IOSEBI617/trezor-hw/README.md

# Hardware design of TREZOR



https://trezor.io/
IOSEBI
