IOSEBI617/trezor-hw/case/trezor_one/usb_c_v2/case.SLDASM

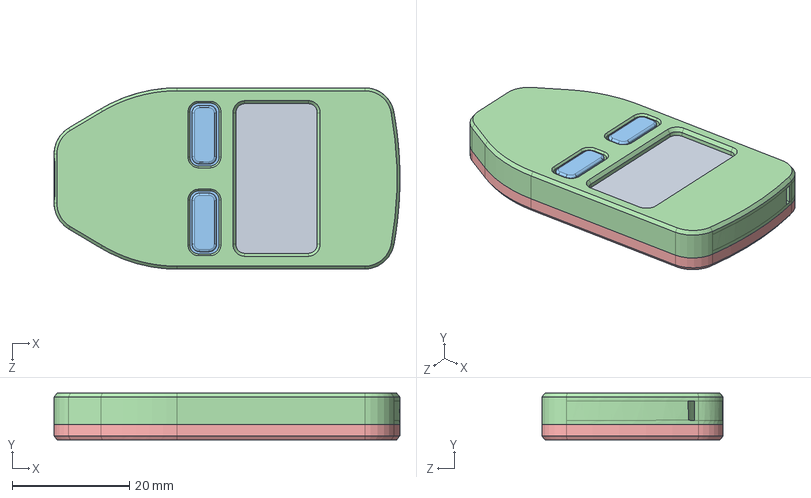
[picture p1: CAD file, 2020-09-01]
case/trezor_one/usb_c_v2/case.SLDASM
58.9 x 7.92 x 30.9 mm
COMPOUND.step
COMPOUND-0.step
SOLID.step
SOLID-1.step x 3
SOLID-2.step x 22
SOLID-3.step
SOLID-4.step
SOLID-5.step
SOLID-6.step x 2
COMPOUND-7.step
buttons
cover-up
cover-down
