IOSEBI617/trezor-hw/case/trezor_one/usb_c_v2/trezor_v1.1_usb_c.SLDASM

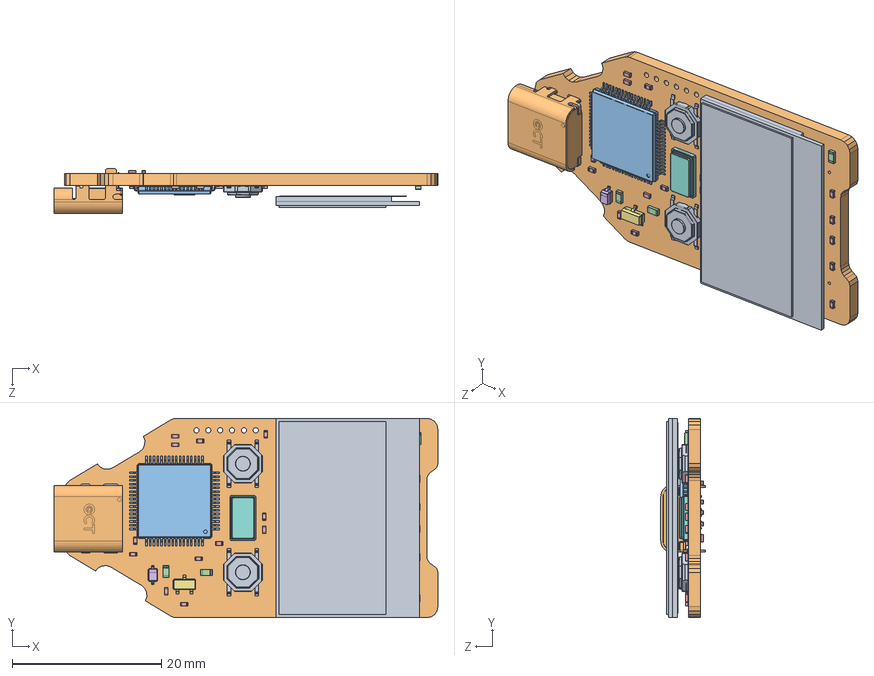
[picture p2: CAD file, 2020-09-01]
case/trezor_one/usb_c_v2/trezor_v1.1_usb_c.SLDASM
51.4 x 26.7 x 5.96 mm
COMPOUND.step
COMPOUND-0.step
SOLID.step
SOLID-1.step x 3
SOLID-2.step x 22
SOLID-3.step
SOLID-4.step
SOLID-5.step
SOLID-6.step x 2
COMPOUND-7.step
