IOSEBI617/trezor-hw/case/trezor_one/v3/buttons.step

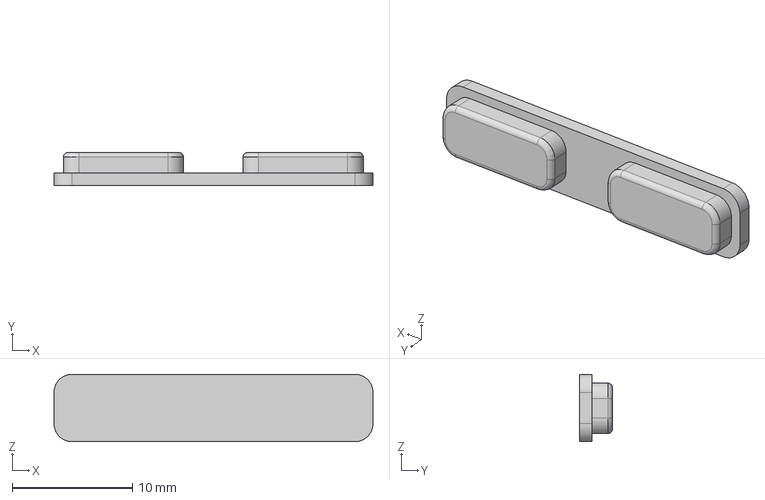
[picture p3: CAD file, 2020-09-01]
case/trezor_one/v3/buttons.step
26.5 x 2.76 x 5.60 mm
