IOSEBI617/trezor-hw/electronics/trezor_v1.1_usb_c/Global_Connector_Technology_-_USB4085-GF-A.step

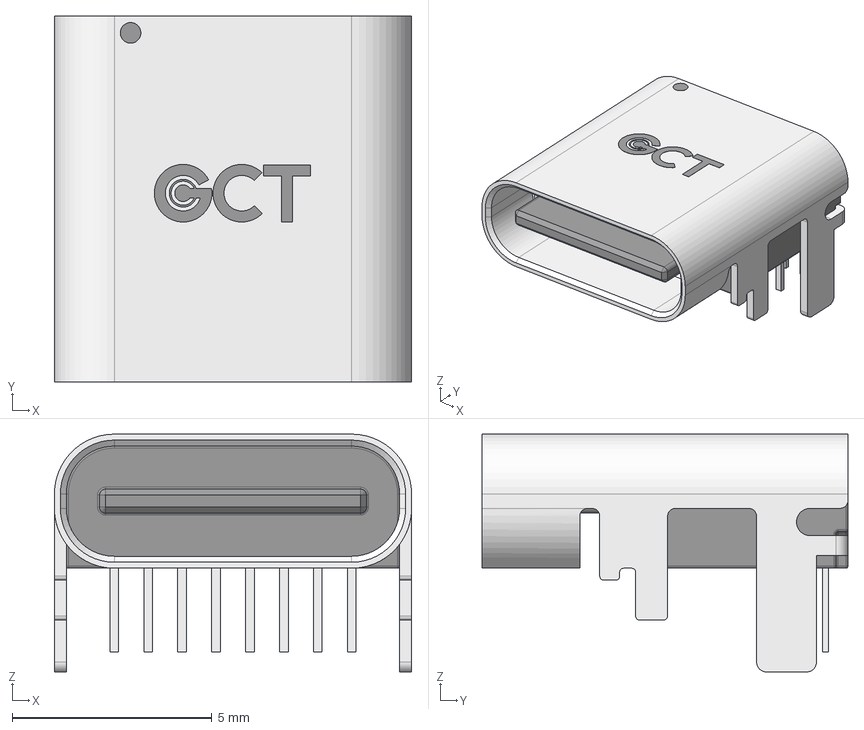
[picture p4: CAD file, 2020-08-25]
electronics/trezor_v1.1_usb_c/Global_Connector_Technology_-_USB4085-GF-A.step
8.95 x 9.17 x 5.96 mm
housing
plastic
pins
logo
