IOSEBI617/trezor-hw/case/trezor_one/v3/cover-up.step

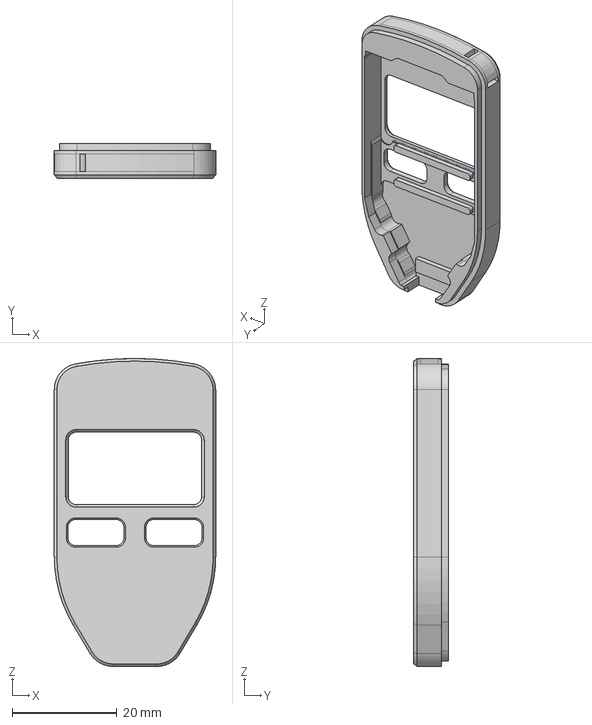
[picture p5: CAD file, 2020-09-01]
case/trezor_one/v3/cover-up.step
30.9 x 6.60 x 58.9 mm
