IOSEBI617/trezor-hw/electronics/trezor_v1.1_usb_c/display.STEP

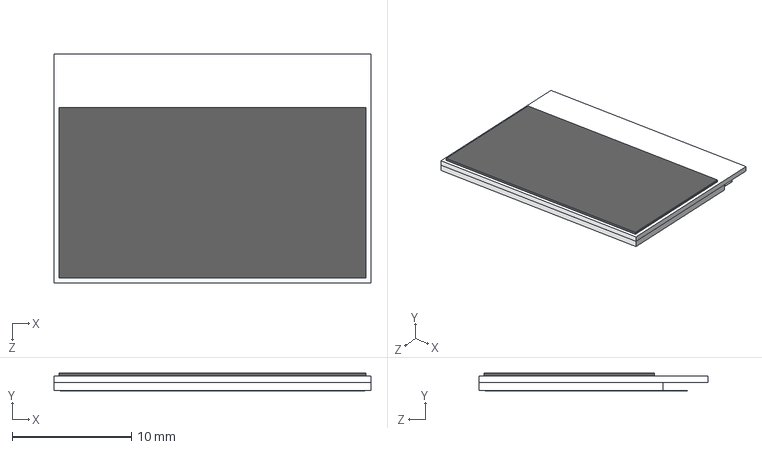
[picture p6: CAD file, 2020-08-25]
electronics/trezor_v1.1_usb_c/display.STEP
26.6 x 1.50 x 19.2 mm
