IOSEBI617/trezor-hw/case/trezor_one/v3/cover-down.step

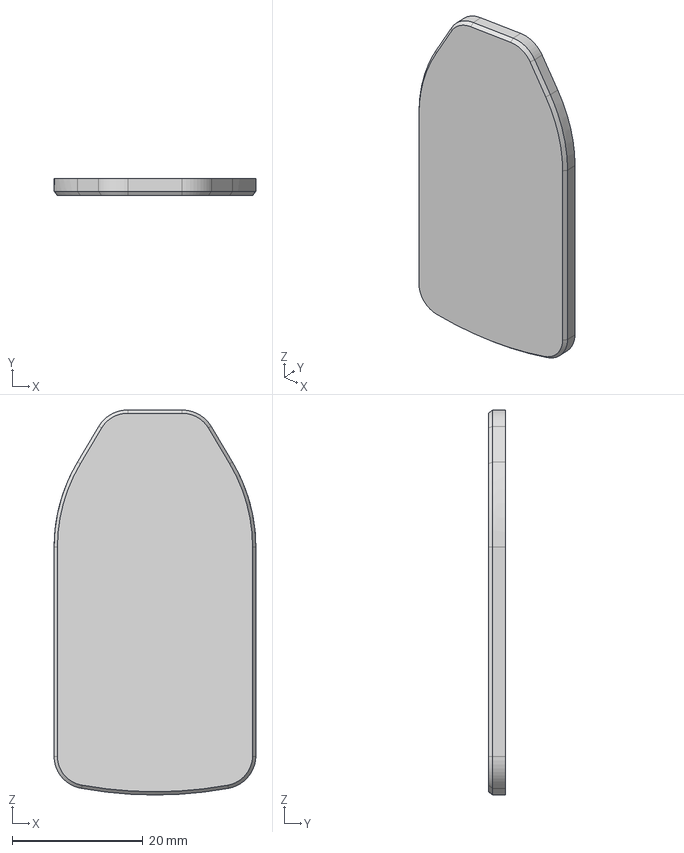
[picture p7: CAD file, 2020-09-01]
case/trezor_one/v3/cover-down.step
30.9 x 2.64 x 58.9 mm
