IOSEBI617/trezor-hw/(list of files, cad)

Other CAD files:
case/trezor_one/usb_c_v2/SOLID-3.step.SLDPRT
case/trezor_one/usb_c_v2/SOLID-5.step.SLDPRT
case/trezor_one/usb_c_v2/SOLID-2.step.SLDPRT
case/trezor_one/usb_c_v2/SOLID-1.step.SLDPRT
case/trezor_one/usb_c_v2/SOLID.step.SLDPRT
case/trezor_one/usb_c_v2/SOLID-4.step.SLDPRT
case/trezor_one/usb_c_v2/cover-down.SLDPRT
case/trezor_one/usb_c_v2/COMPOUND.step.SLDPRT
case/trezor_one/usb_c_v2/SOLID-6.step.SLDPRT
case/trezor_one/usb_c_v2/COMPOUND-0.step.SLDPRT
case/trezor_one/usb_c_v2/cover-up.SLDPRT
case/trezor_one/usb_c_v2/buttons.SLDPRT
case/trezor_one/usb_c/buttons2.SLDPRT
case/trezor_one/usb_c/buttons2.STL
case/trezor_one/usb_c/case.SLDASM
case/trezor_one/usb_c/cover-down-fixed.SLDPRT
case/trezor_one/usb_c/cover-down-v2.SLDPRT
case/trezor_one/usb_c/cover-down-v2.STL
case/trezor_one/usb_c/cover-down.SLDPRT
case/trezor_one/usb_c/cover-up-v2.STL
case/trezor_one/usb_c/cover-up1.SLDPRT
case/trezor_one/usb_c/trezor_v1.1_usb_c.SLDASM
case/trezor_one/usb_c_v2/buttons.STL
case/trezor_one/usb_c_v2/cover-down.STL
case/trezor_one/usb_c_v2/cover-up.STL
electronics/trezor_v1.1_usb_c/display.SLDPRT
