IOSEBI617/trezor-hw/electronics/trezor_v1.1_usb_c/trezor_v1.1.kicad_pcb

## KiCad design electronics/trezor_v1.1_usb_c/trezor_v1.1.kicad_pcb (2020-08-25)

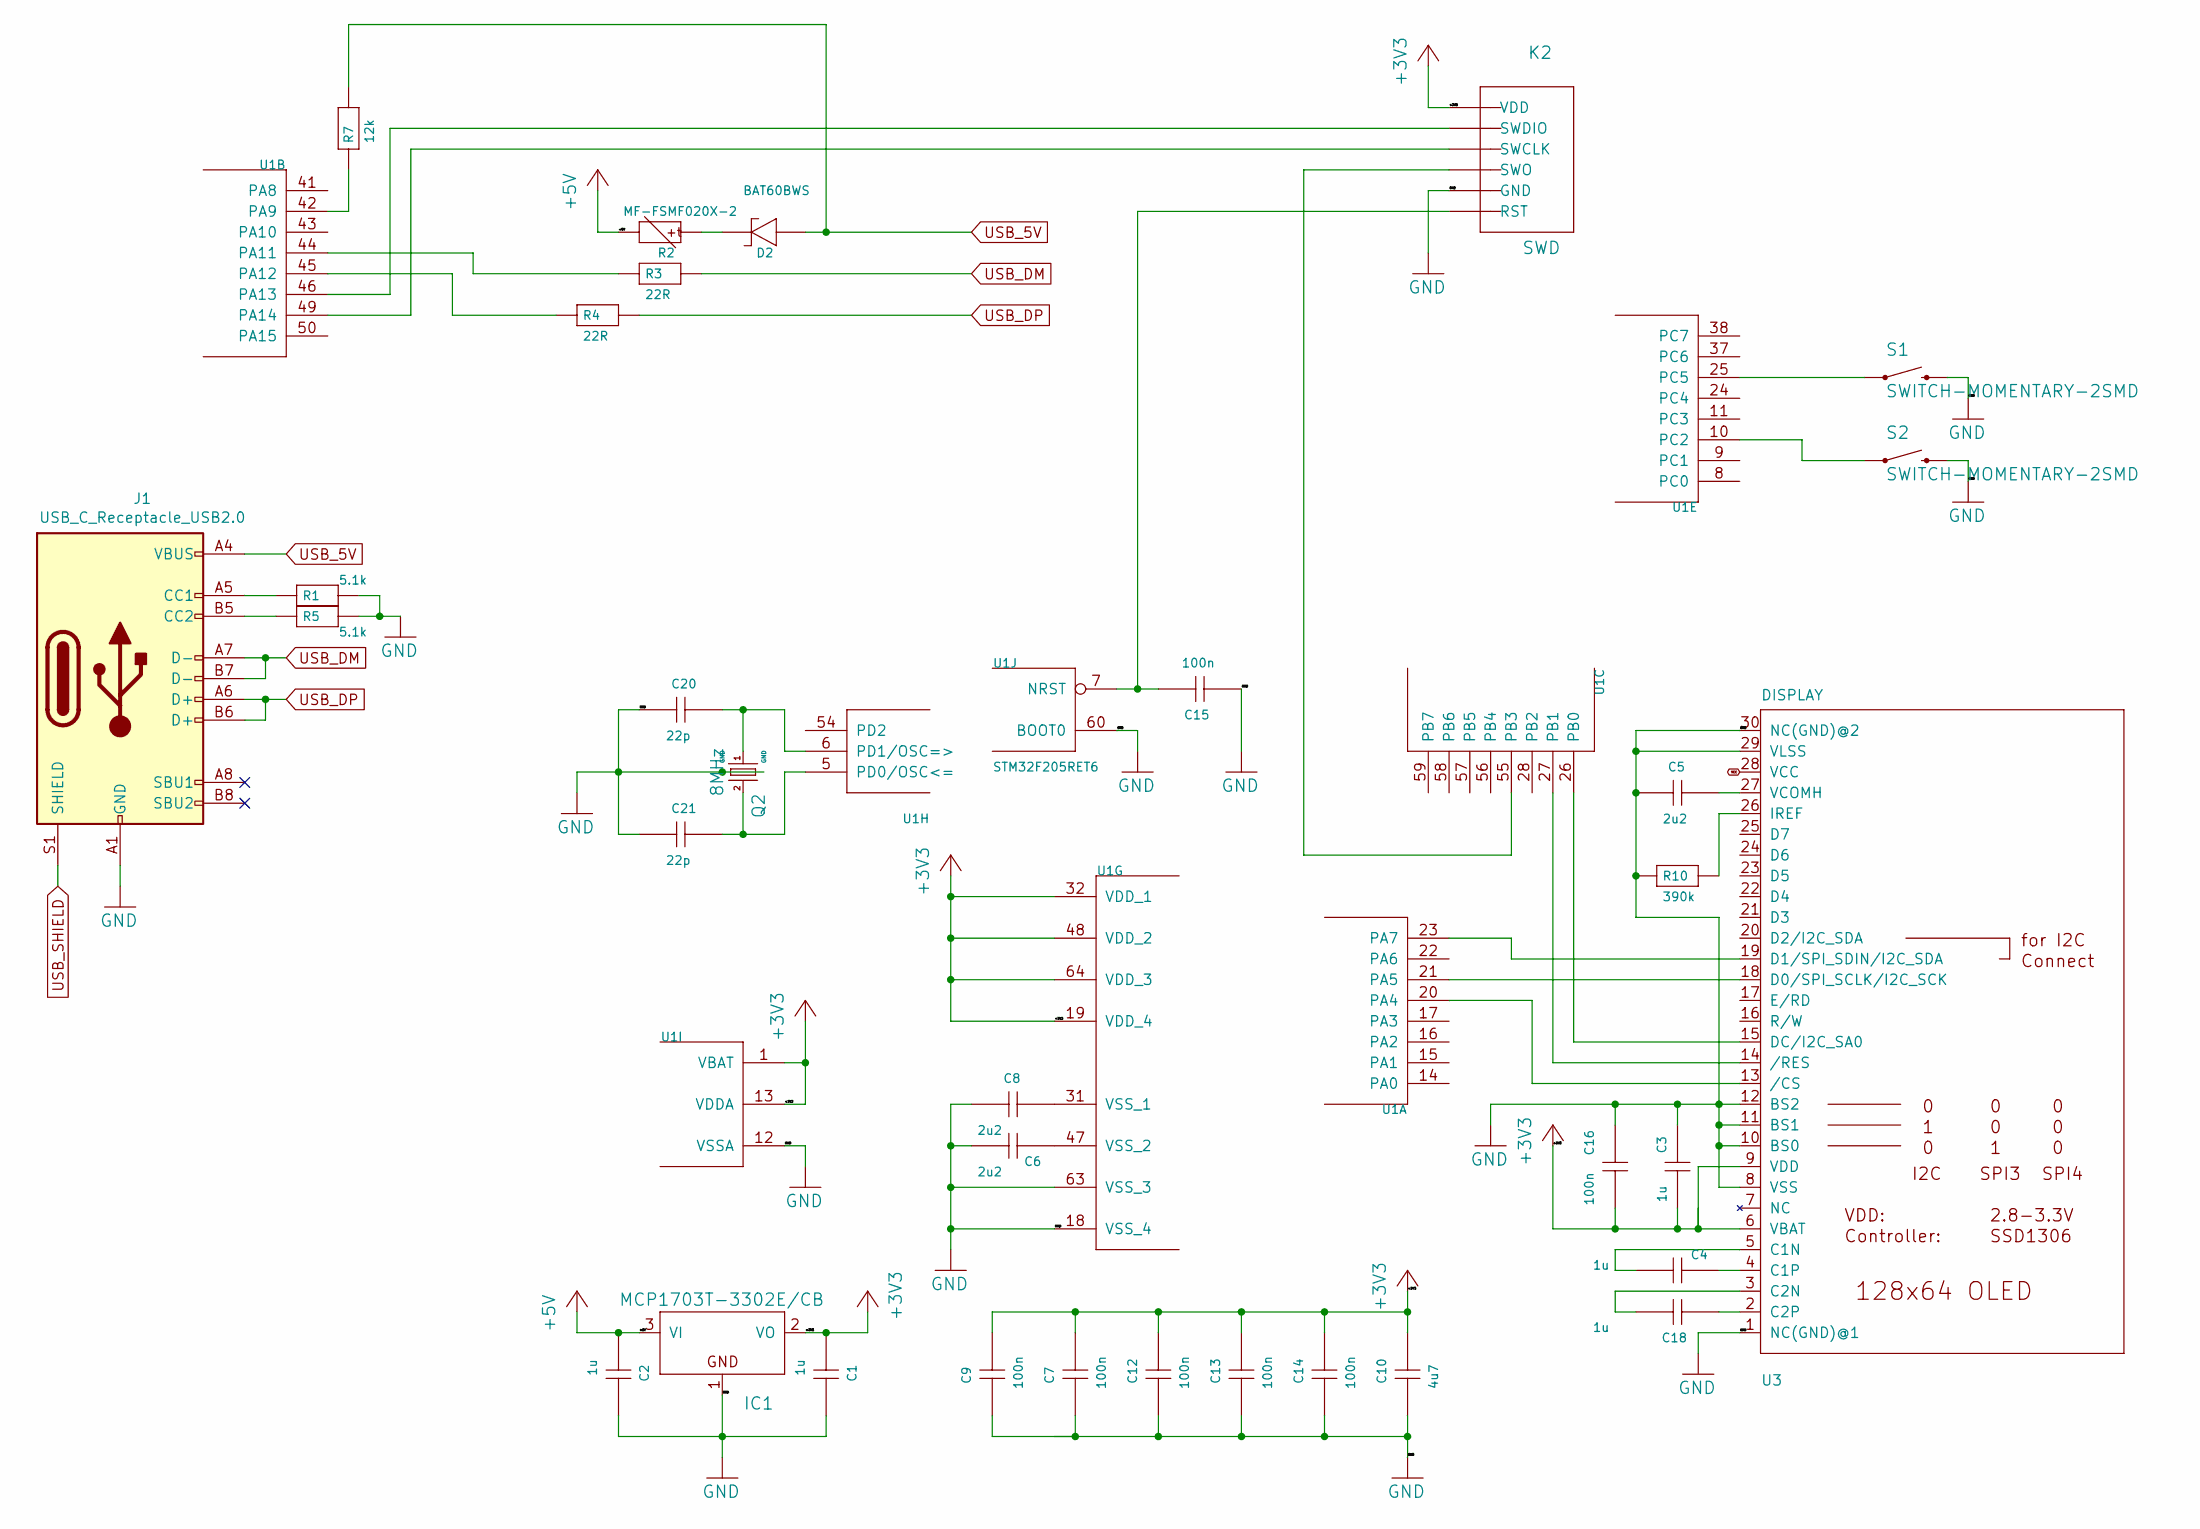
[picture p8: schematic trezor_v1.1.sch]

Parts:
C1, C2, C3, C4, C18: 1u; 0402
C5: 2u2; 0603
C6, C8: 2u2; 0402
C7, C9, C12, C13, C14, C15, C16: 100n; 0402
C10: 4u7; 0603
C20, C21: 22p; 0402
D2: BAT60BWS; SOD323
IC1: MCP1703T-3302E/CB; SOT23
J1: USB_C_Receptacle_USB2.0; USB_C_Receptacle_GCT_USB4085
K2: SWD
Q2: 8MHz; CTS406
R1, R5: 5.1k; 0402
R2: MF-FSMF020X-2; 0603
R3, R4: 22R; 0402
R7: 12k; 0402
R10: 390k; 0402
S1, S2: SWITCH-MOMENTARY-2SMD; TACTILE_SWITCH_SMD
U1: STM32F205RET6; TQFP64
U3: DISPLAY; UG-2864HSWEG01_0.96IN_WRAPAROUND

Connections:
+3V3: C1.P$1 (1), C3.P$1 (1), C7.P$2 (2), C9.P$2 (2), C10.2, C12.P$2 (2), C13.P$2 (2), C14.P$2 (2), C16.P$1 (1), IC1.2 (VO), K2.6 (VDD), U1.1 (VBAT), U1.13 (VDDA), U1.19 (VDD_4), U1.32 (VDD_1), U1.48 (VDD_2), U1.64 (VDD_3), U3.6 (VBAT), U3.9 (VDD)
+5V: C2.P$1 (1), IC1.3 (VI), R2.2
GND: C1.P$2 (2), C2.P$2 (2), C3.P$2 (2), C5.1, C6.P$1 (1), C7.P$1 (1), C8.P$1 (1), C9.P$1 (1), C10.1, C12.P$1 (1), C13.P$1 (1), C14.P$1 (1), C15.P$1 (1), C16.P$2 (2), C20.P$1 (1), C21.P$1 (1), IC1.1 (GND), J1.A1 (GND), J1.A12 (GND), J1.B1 (GND), J1.B12 (GND), K2.2 (GND), Q2.2 (GND), Q2.4 (GND), R1.P$2 (2), R5.P$2 (2), R10.P$1 (1), S1.3 (2), S1.4 (2), S2.3 (2), S2.4 (2), U1.12 (VSSA), U1.18 (VSS_4), U1.60 (BOOT0), U1.63 (VSS_3), U3.1 (NC(GND)@1), U3.8 (VSS), U3.10 (BS0), U3.11 (BS1), U3.12 (BS2), U3.29 (VLSS), U3.30 (NC(GND)@2)
unnamed: C4.P$1 (1), U3.4 (C1P)
unnamed: C4.P$2 (2), U3.5 (C1N)
unnamed: C5.2, U3.27 (VCOMH)
unnamed: C6.P$2 (2), U1.47 (VSS_2)
unnamed: C8.P$2 (2), U1.31 (VSS_1)
unnamed: C15.P$2 (2), K2.1 (RST), U1.7 (NRST)
unnamed: C18.P$1 (1), U3.2 (C2P)
unnamed: C18.P$2 (2), U3.3 (C2N)
unnamed: C20.P$2 (2), Q2.1, U1.6 (PD1/OSC=>)
unnamed: C21.P$2 (2), Q2.3 (2), U1.5 (PD0/OSC<=)
unnamed: D2.K (2), R2.1
unnamed: J1.A5 (CC1), R1.P$1 (1)
unnamed: J1.B5 (CC2), R5.P$1 (1)
unnamed: K2.3 (SWO), U1.55 (PB3)
unnamed: K2.4 (SWCLK), U1.49 (PA14)
unnamed: K2.5 (SWDIO), U1.46 (PA13)
unnamed: R3.P$1 (1), U1.44 (PA11)
unnamed: R4.P$1 (1), U1.45 (PA12)
unnamed: R7.P$1 (1), U1.42 (PA9)
unnamed: R10.P$2 (2), U3.26 (IREF)
unnamed: S1.1, S1.2 (1), U1.25 (PC5)
unnamed: S2.1, S2.2 (1), U1.10 (PC2)
unnamed: U1.20 (PA4), U3.13 (/CS)
unnamed: U1.21 (PA5), U3.18 (D0/SPI_SCLK/I2C_SCK)
unnamed: U1.23 (PA7), U3.19 (D1/SPI_SDIN/I2C_SDA)
unnamed: U1.26 (PB0), U3.15 (DC/I2C_SA0)
unnamed: U1.27 (PB1), U3.14 (/RES)
USB_5V: D2.A (1), J1.A4 (VBUS), J1.A9 (VBUS), J1.B4 (VBUS), J1.B9 (VBUS), R7.P$2 (2)
USB_DM: J1.A7 (D-), J1.B7 (D-), R3.P$2 (2)
USB_DP: J1.A6 (D+), J1.B6 (D+), R4.P$2 (2)
USB_SHIELD: J1.S1 (SHIELD)
VCC: U3.28 (VCC)

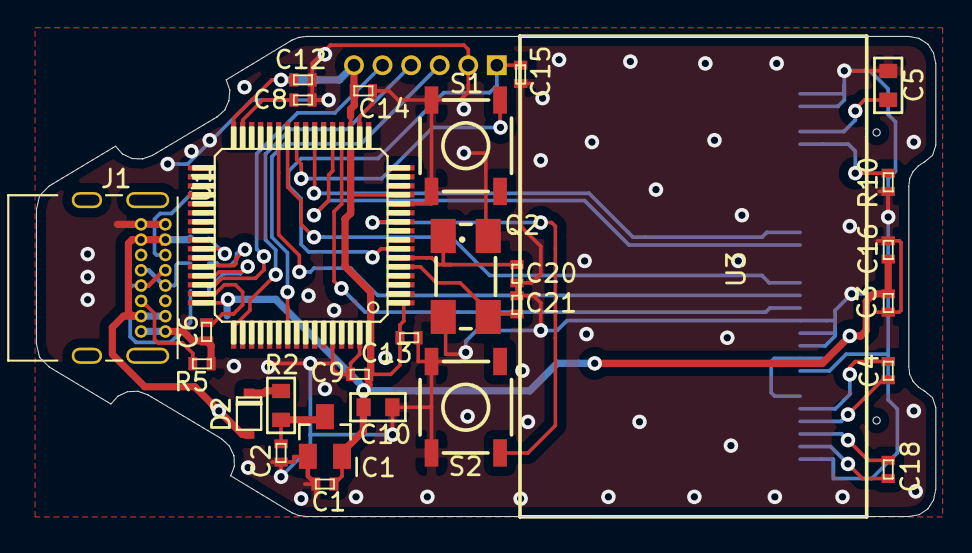
[picture p9: board trezor_v1.1.kicad_pcb from above]

Board: 2 copper layers, 50.0 x 26.7 mm, 34 parts (0 on the bottom side), 33 nets.
