IOSEBI617/trezor-hw/(commit log)

2020-07-12 Add USB-C version of Trezor One
    [trezor_v1.1.kicad_pcb, trezor_v1.1.sch]
2020-07-12 Fix silkscreen text
    [trezor_v1.1.kicad_pcb]
2020-07-12 Minor silkscreen fixes, add specifier for JLC order number
    [trezor_v1.1.kicad_pcb]
2020-07-13 Fix solder mask on all footprints, minor trace cleanup
    [trezor_v1.1.kicad_pcb]
2020-07-13 Minor silkscreen fixes
    [trezor_v1.1.kicad_pcb]
2020-08-25 Add 3D models to kicad pcb
    [Global_Connector_Technology_-_USB4085-GF-A.step, display.SLDPRT, display.STEP, trezor_v1.1.kicad_pcb]
2020-08-25 Fix display 3d model location
    [trezor_v1.1.kicad_pcb]
2020-08-25 Add case CAD files and STLs
    [buttons2.SLDPRT, buttons2.STL, case.SLDASM, cover-down-fixed.SLDPRT, cover-down-v2.SLDPRT, cover-down-v2.STL, cover-down.SLDPRT, cover-up-v2.STL]
2020-09-01 Add STEP recreations of v3 housing
    [buttons.step, cover-down.step, cover-up.step]
2020-09-01 Create case using v3 files
    [COMPOUND-0.step.SLDPRT, COMPOUND.step.SLDPRT, SOLID-1.step.SLDPRT, SOLID-2.step.SLDPRT, SOLID-3.step.SLDPRT, SOLID-4.step.SLDPRT, SOLID-5.step.SLDPRT, SOLID-6.step.SLDPRT]
